PRJ2GR15/HardwareDesign/README.md

# HardwareDesign
Til Hardware design dokumenter
