PRJ2GR15/HardwareDesign/Komponentliste_X10.1.docx

X10.1 styreboks

2 stk rød banastik hun

1 stk sort bananstik hun

1 stk 6 pin harwin han

Ledning

2 stk gul LED 5 mm

1 stk grøn LED 5 mm

Voltage converter

1 stk ICL7660

2 stk 10 µF elektrolyt kondensator

Sender-del

1 stk BC547B

1 stk 4.3 kohm modstand

1 stk 250 ohm modstand

1 stk 10 kohm modstand

1 stk 10 nF film kodensator

Modtager-del

1 stk AD823

2 stk 3.3 nF keramisk kondensator

1 stk 10 nF film kondensator

1 stk 270 ohm modstand

3 stk 1 kohm modstand

1 stk 10 kohm modstand

1 stk 3 kohm modstand

1 stk 1N4007

2 stk 470 nF film kondensator

Zero Cross detektor

2 stk 470 nF film kondensator

2 stk 1N4007

3 stk 5.1 kohm modstand

2 stk 100 kohm modstand

2 stk 10 Mohm modstand

1 stk 10 kohm modstand

X10.1 enhed

2 stk rød banastik hun

1 stk sort bananstik hun

1 stk 6 pin harwin han

Ledning

1 stk gul LED 5 mm

1 stk grøn LED 5 mm

1 stk V23047-A1012-A501 relæ

Voltage converter

1 stk ICL7660

2 stk 10 µF elektrolyt kondensator

Sender-del

1 stk BC547B

1 stk 4.3 kohm modstand

1 stk 250 ohm modstand

1 stk 10 kohm modstand

1 stk 10 nF film kodensator

Modtager-del

1 stk AD823

2 stk 3.3 nF keramisk kondensator

1 stk 10 nF film kondensator

1 stk 270 ohm modstand

3 stk 1 kohm modstand

1 stk 10 kohm modstand

1 stk 3 kohm modstand

1 stk 1N4007

2 stk 470 nF film kondensator

Zero Cross detektor

2 stk 470 nF film kondensator

2 stk 1N4007

3 stk 5.1 kohm modstand

2 stk 100 kohm modstand

2 stk 10 Mohm modstand

1 stk 10 kohm modstand
