PRJ2GR15/HardwareDesign/X10.1/bodeplot fra analog på båndpasfilter/bodeplotbåndpasfilterprojekt2.png

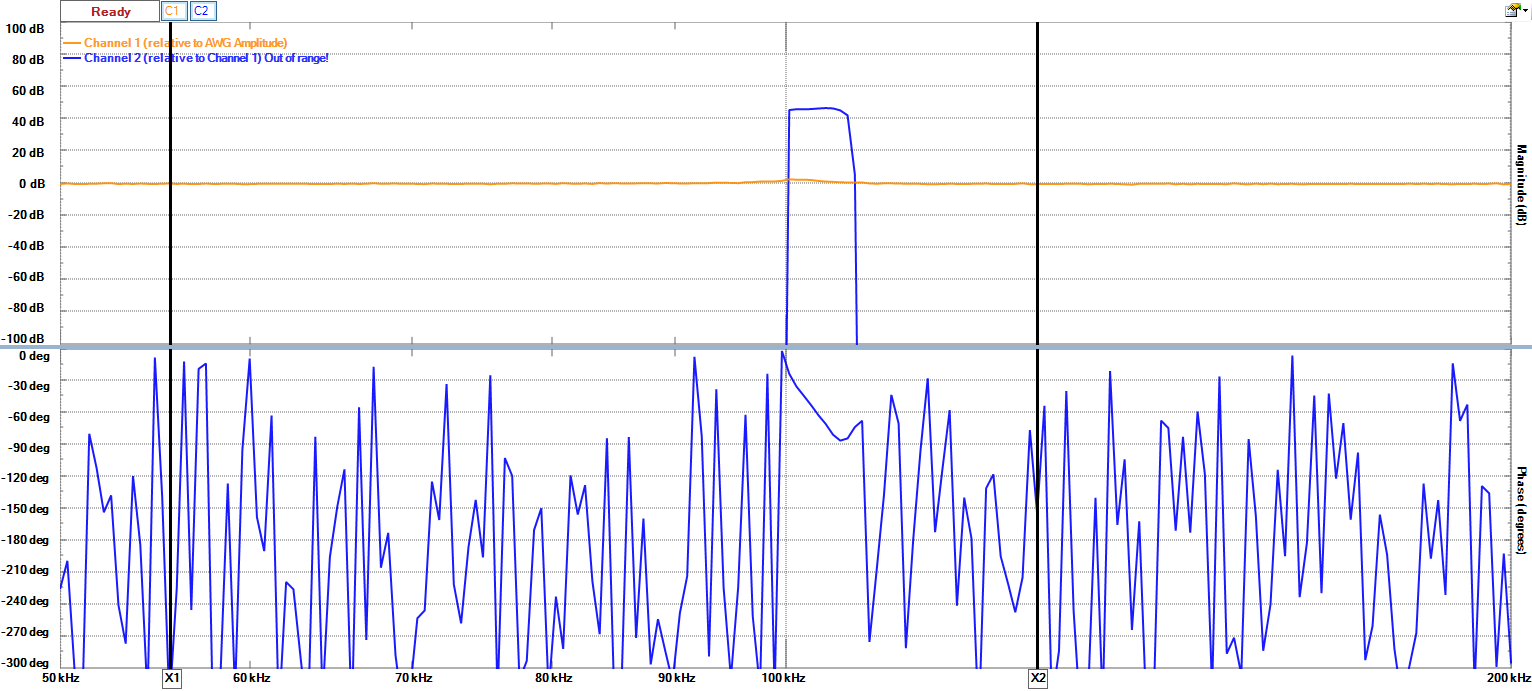
X10.1/bodeplot fra analog på båndpasfilter/bodeplotbåndpasfilterprojekt2.png
