PRJ2GR15/HardwareDesign/X10.1/Dokumentation/Nyeste sender og modtager 50 Hz.PNG

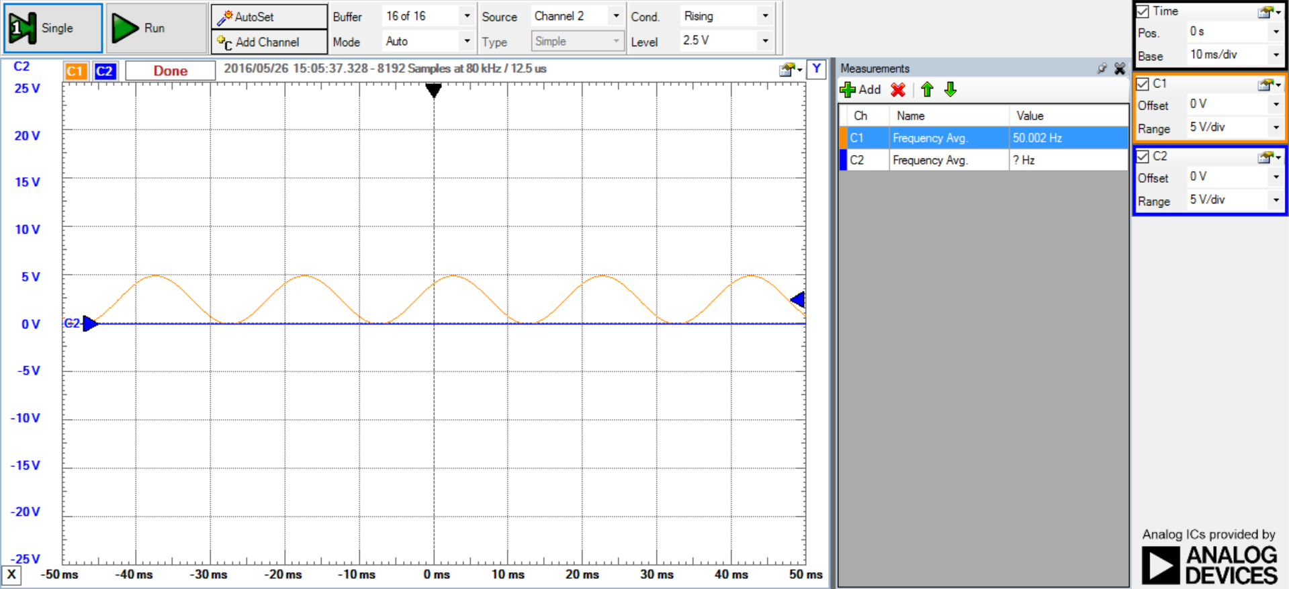
X10.1/Dokumentation/Nyeste sender og modtager 50 Hz.PNG
