PRJ2GR15/HardwareDesign/X10.1/Dokumentation/nyeste sender og modtager ved 120 kHz.PNG

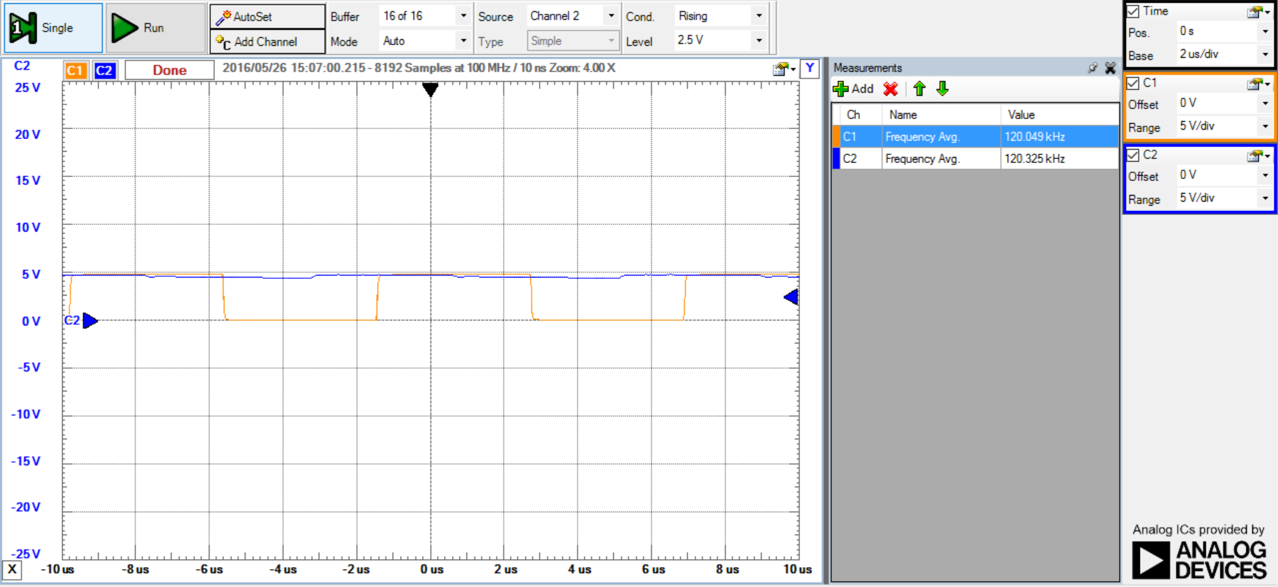
X10.1/Dokumentation/nyeste sender og modtager ved 120 kHz.PNG
