PRJ2GR15/HardwareDesign/X10.1/Dokumentation/Sender kredsløb/nyt-transmitter-indgang-udgang-oscilloscope.png

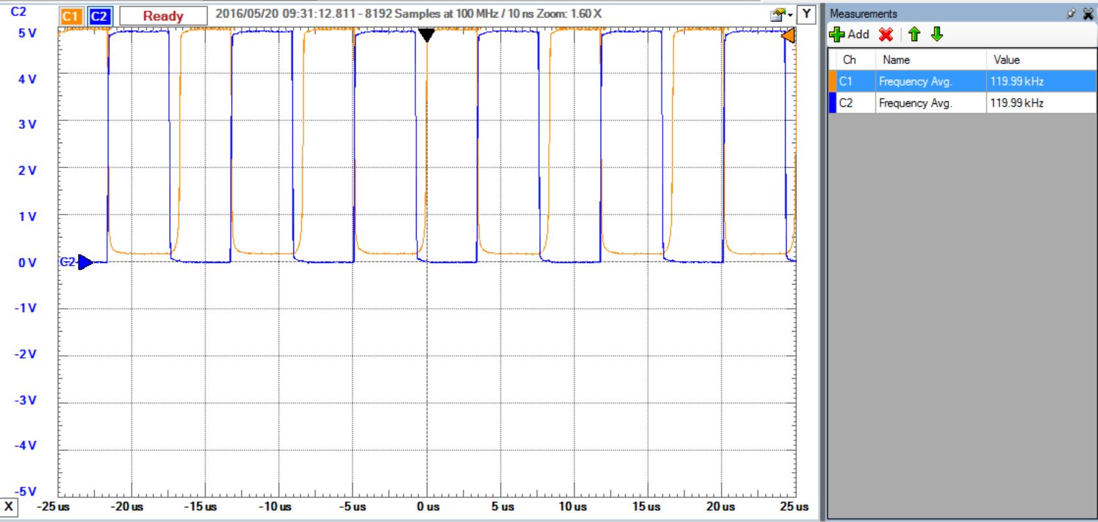
X10.1/Dokumentation/Sender kredsløb/nyt-transmitter-indgang-udgang-oscilloscope.png
