PRJ2GR15/HardwareDesign/X10.1/Dokumentation/Sender kredsløb/Senderkredsløb oscilloscope.PNG

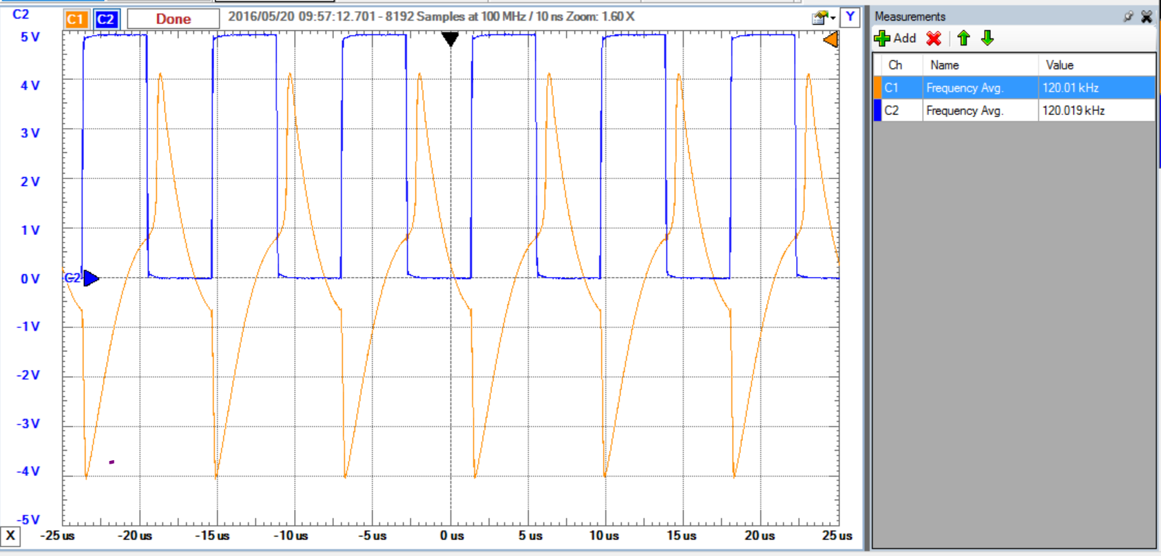
X10.1/Dokumentation/Sender kredsløb/Senderkredsløb oscilloscope.PNG
