PRJ2GR15/HardwareDesign/X10.1/Dokumentation/Zero cross 18V AC.PNG

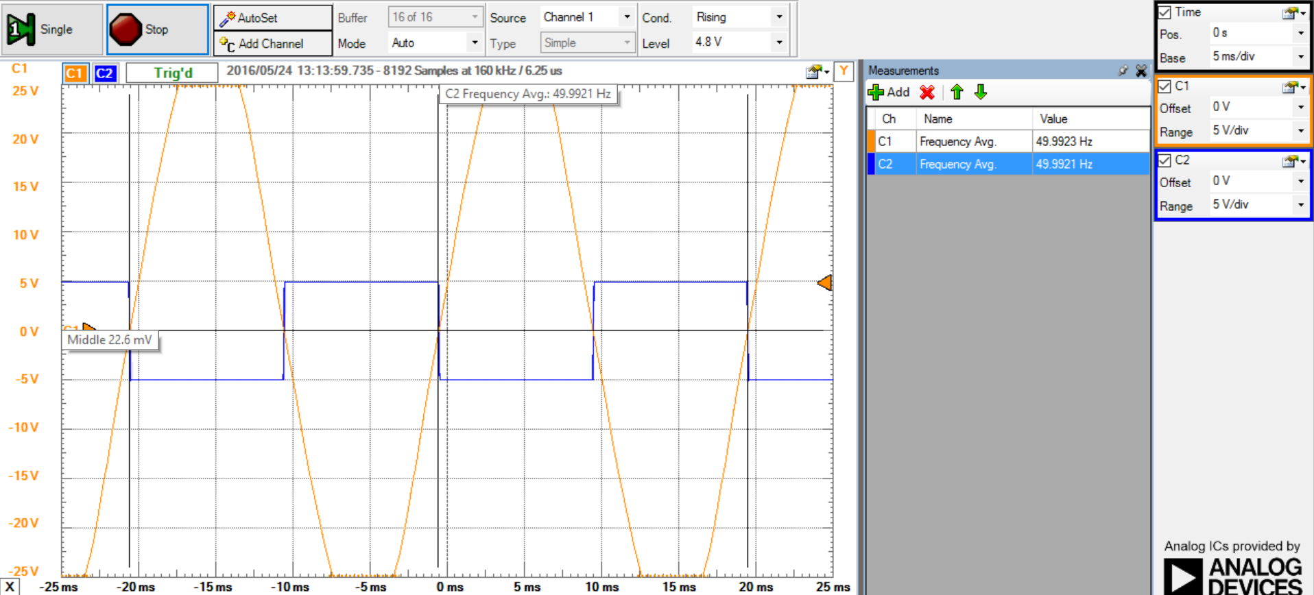
X10.1/Dokumentation/Zero cross 18V AC.PNG
