PRJ2GR15/HardwareDesign/(list of files, drawings)

Other design files:
X10.1/Dokumentation/1. ordens sende plus modtager kredsløb det virker!.ms14
X10.1/Dokumentation/Envelope detector med 2. ordens højpas filter.ms14
X10.1/Dokumentation/Voltage inverter.ms14
X10.1/Forslag til zero-cross-kredsløb/Design1-ud-fra-det-kredsløb-vi-tegnede-i-starten.ms14
X10.1/Forslag til zero-cross-kredsløb/Design2-bare-et-eksperiment-men-virker-i-mutisim14.ms14
X10.1/Forslag til zero-cross-kredsløb/Design3-ud-fra-datasheet-LM311.ms14
X10.1/Forslag til zero-cross-kredsløb/Design4-ud-fra-LM339-datasheet.ms14
X10.1/Forslag til zero-cross-kredsløb/Zero cross fra LM339 datasheet.ms14
X10.1/højpas/andenordens/forsøgmedhøjpas.ms14
X10.1/højpas/andenordens/højpassimuleringmedsenderogmodtager.ms14
X10.1/højpas/Design1.ms14
X10.1/højpas/Design2.ms14
X10.1/Nyt senderkredsløb/Envelope detector med 2. ordens højpas filter.ms14
X10.1/Tonni.Samlet.Forslag.Sammenhæng/højpasfilter/aktivthøjpas.ms14
X10.1/Tonni.Samlet.Forslag.Sammenhæng/samlet modtager.ms14
X10.1/Tonni.Samlet.Forslag.Sammenhæng/SamletSenderkredsløb.ms14
X10.1/Tonni.Samlet.Forslag.Sammenhæng/Samletx10.1.setup.ms14
X10.1/Tonni.Samlet.Forslag.Sammenhæng/SenderTransistorkreds/transitorkredsløb.ms14
X10.1/Tonni.Samlet.Forslag.Sammenhæng/Zero-Cross/Zerp-Cross-LM339-datasheet.ms14
X10.1/x10.1-senderkredsløb/x10.1transmitter-medafkobling.ms13
X10.1/x10.1-senderkredsløb/x10.1transmitter.ms13
