PRJ2GR15/HardwareDesign/(commit log)

2016-05-17 added files from the arkitektur repo, and added my calculations on the transmitter circuit and a diagram that needs testing.
    [x10.1transmitter.ms13]
2016-05-17 lidt beregninger for at tilpasse afkoblingskredsløbet
    [x10.1transmitter-medafkobling.ms13]
2016-05-17 tilføjet multisim14 simuleringer af nogle mulige zero-cross kredsløb. den ene er pulled out of my ass, de 2 er taget fra datasheets på de comparators de bruger, og den 1. er ud fra den tegning vi lav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
    [Design1-ud-fra-det-kredsløb-vi-tegnede-i-starten.ms14, Design2-bare-et-eksperiment-men-virker-i-mutisim14.ms14, Design3-ud-fra-datasheet-LM311.ms14, Design4-ud-fra-LM339-datasheet.ms14]
2016-05-18 højpas
    [Design1.ms14, Design2.ms14]
2016-05-19 added andenordens/forsøgmedhøjpas.mcdx and so forth, a test simulation with sender reciever filters comming up soon.
    [forsøgmedhøjpas.ms14]
2016-05-19 nu med simulering af sender og modtager filtre. med funktionsgenerator som senderkreds så der kan simuleres med både firkant og sinus.
    [højpassimuleringmedsenderogmodtager.ms14]
2016-05-20 added a bunch of explanations and my thoughts on a complete x10.1 system since i'm still laying ill and some of it seemed to confuse people, try and see if you can work your way through it all ;)
    [SamletSenderkredsløb.ms14, Samletx10.1.setup.ms14, Zerp-Cross-LM339-datasheet.ms14, aktivthøjpas.ms14, samlet modtager.ms14, transitorkredsløb.ms14]
2016-05-20 updateret Samletx10.1.setup.ms14 da jeg havde glemt 5 V på transistoren (facepalm)
    [Samletx10.1.setup.ms14]
2016-05-24 updated Forslag til zero-cross-kredsløb/Design4-ud-fra-LM339-datasheet.ms14
    [Design4-ud-fra-LM339-datasheet.ms14]
2016-05-25 Nyt senderkredsløb/Envelope detector med 2. ordens højpas filter.ms14
    [Envelope detector med 2. ordens højpas filter.ms14]
2016-05-26 updated Tonni.Samlet.Forslag.Sammenhæng/SamletSenderkredsløb.ms14
    [SamletSenderkredsløb.ms14]
2016-05-26 added 1. ordens sender og modtager kredsløb samt Voltage inverter.ms14
    [1. ordens sende plus modtager kredsløb det virker!.ms14, Voltage inverter.ms14]
2016-05-26 updated Multisim Zero cross detector
    [Design4-ud-fra-LM339-datasheet.ms14]
2016-05-26 added Zero cross fra LM339 datasheet.ms14
    [Zero cross fra LM339 datasheet.ms14]
2016-05-26 updated Sender kredsløbet
    [SamletSenderkredsløb.ms14]
2016-05-26 tilføjet x10.1 Uden zerocross(passivt filter).LM4
2016-05-26 Added Modtager kredsløb med 2. ordens filter + oscilloscope pics
    [Envelope detector med 2. ordens højpas filter.ms14]
2016-05-27 added Print sender, modtager, zero cross samt spændingsregulator.LM4 . SE EFTER I DIAGRAMMER FOR AT VÆRE SIKKER!!
2016-05-27 updated Envelope detector med 2. ordens højpas filter.ms14
    [Envelope detector med 2. ordens højpas filter.ms14]
2016-06-09 Ændret Til projektdokumentation/X10.1 printudlæg.docx
